Open-Racing-Telemetry/rtlm/README.md

<p align="center">
  
</p>
