Open-Racing-Telemetry/rtlm/kicad/rtlm/rtlm.kicad_pcb

## KiCad design kicad/rtlm/rtlm.kicad_pcb (2026-10-19)

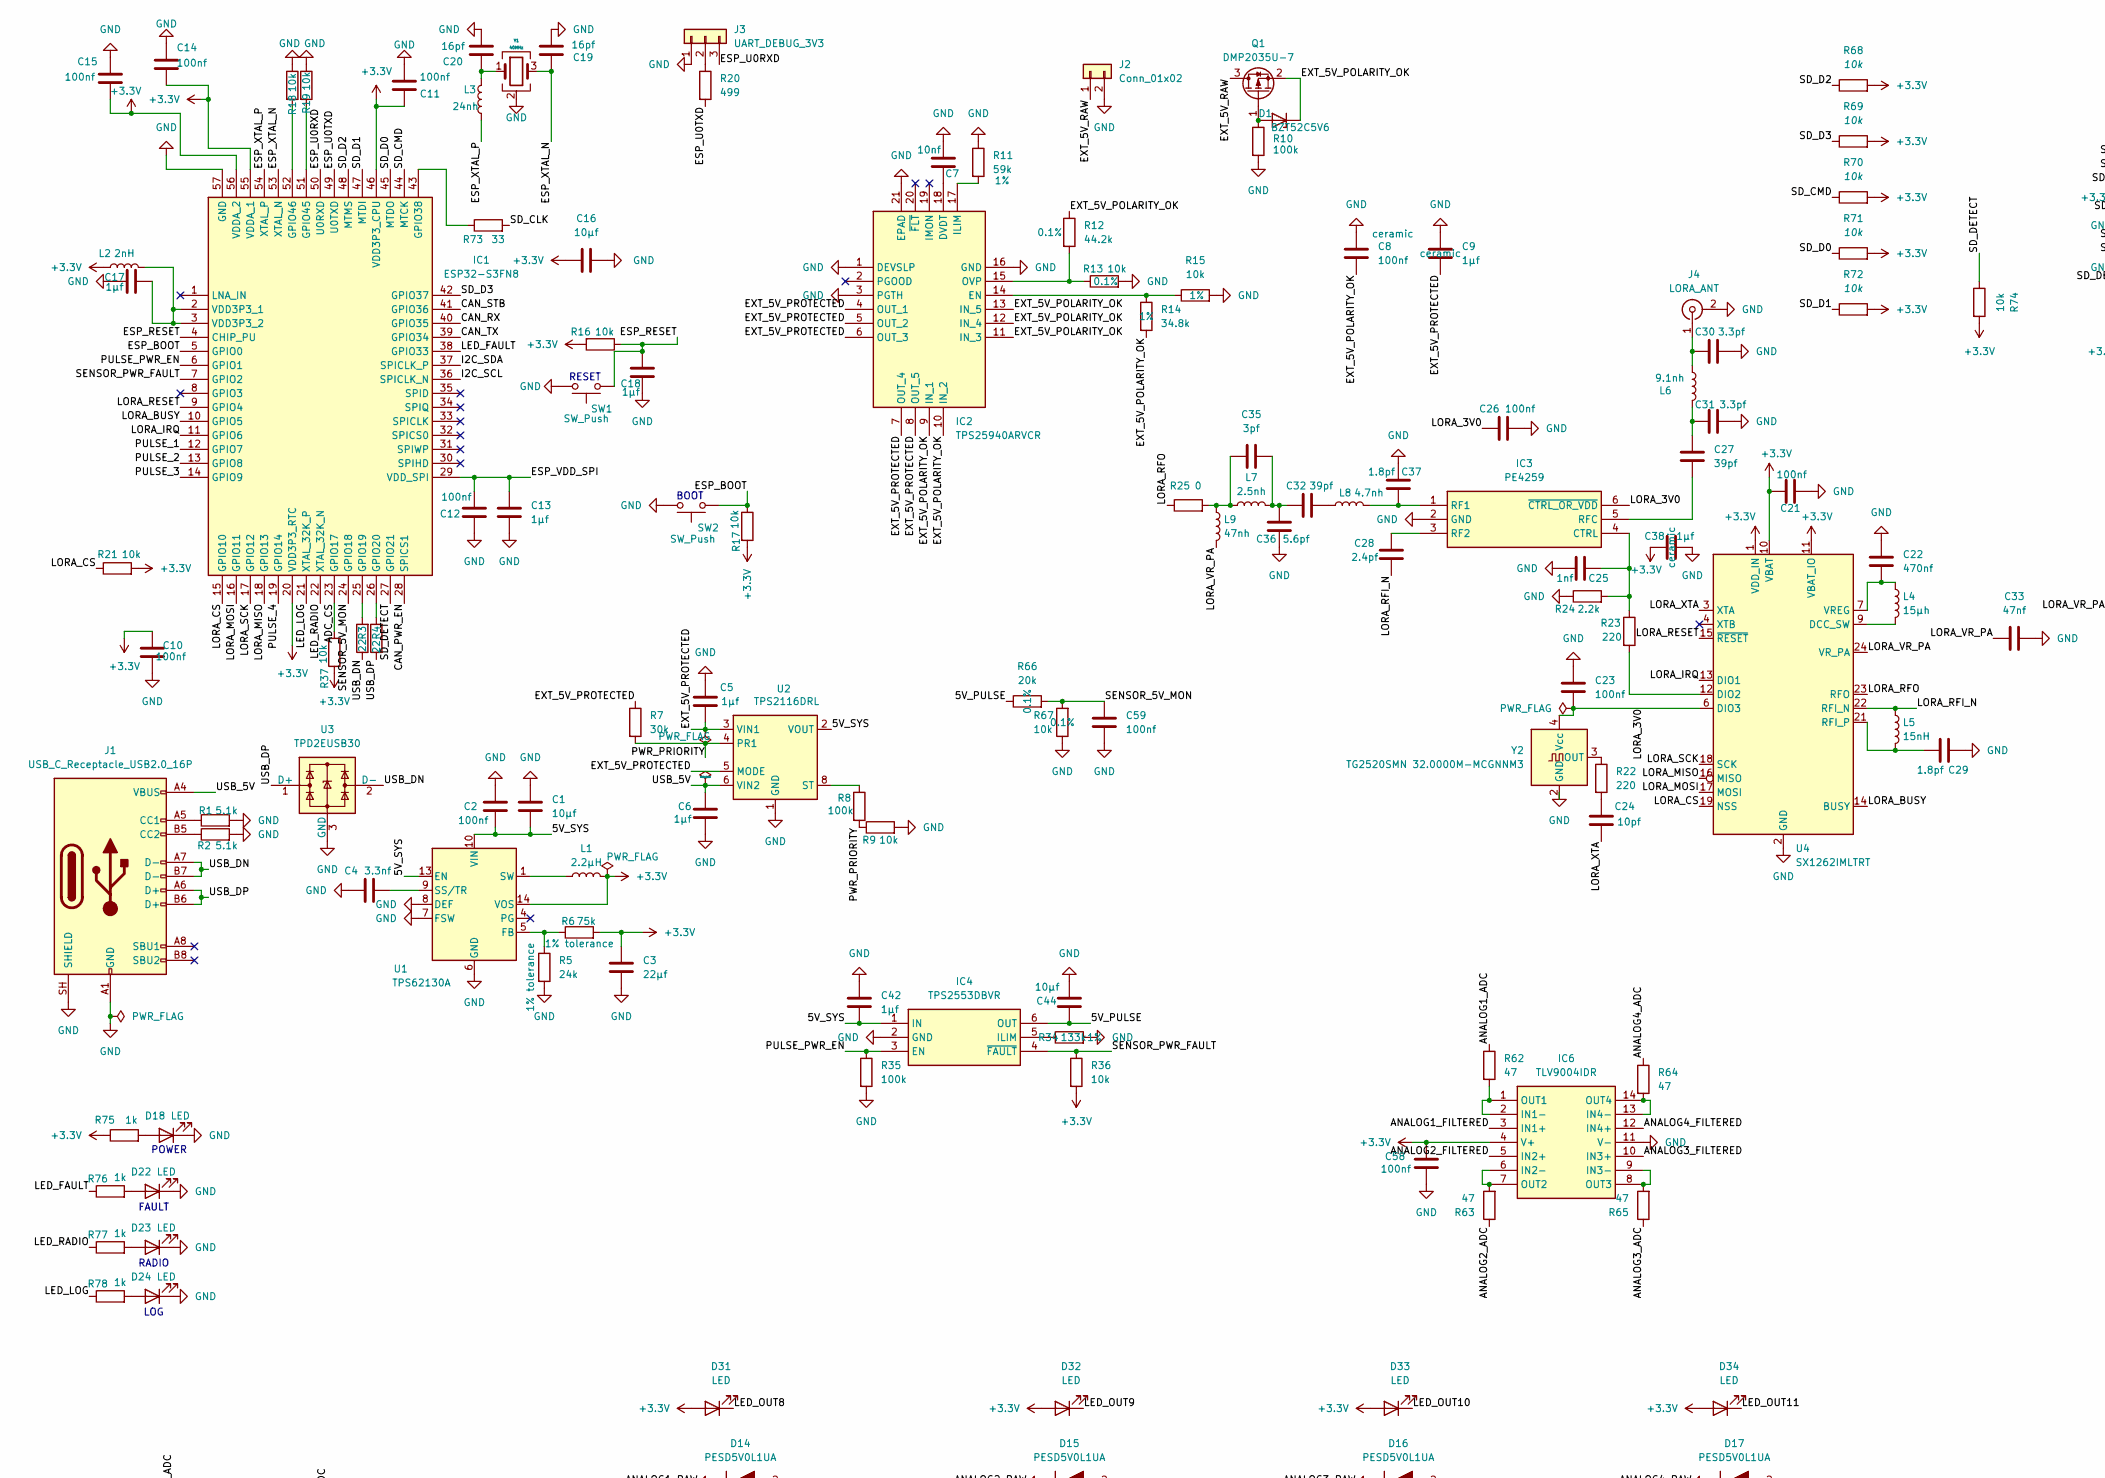
[picture p1: schematic rtlm.kicad_sch, part in row 1, column 1]

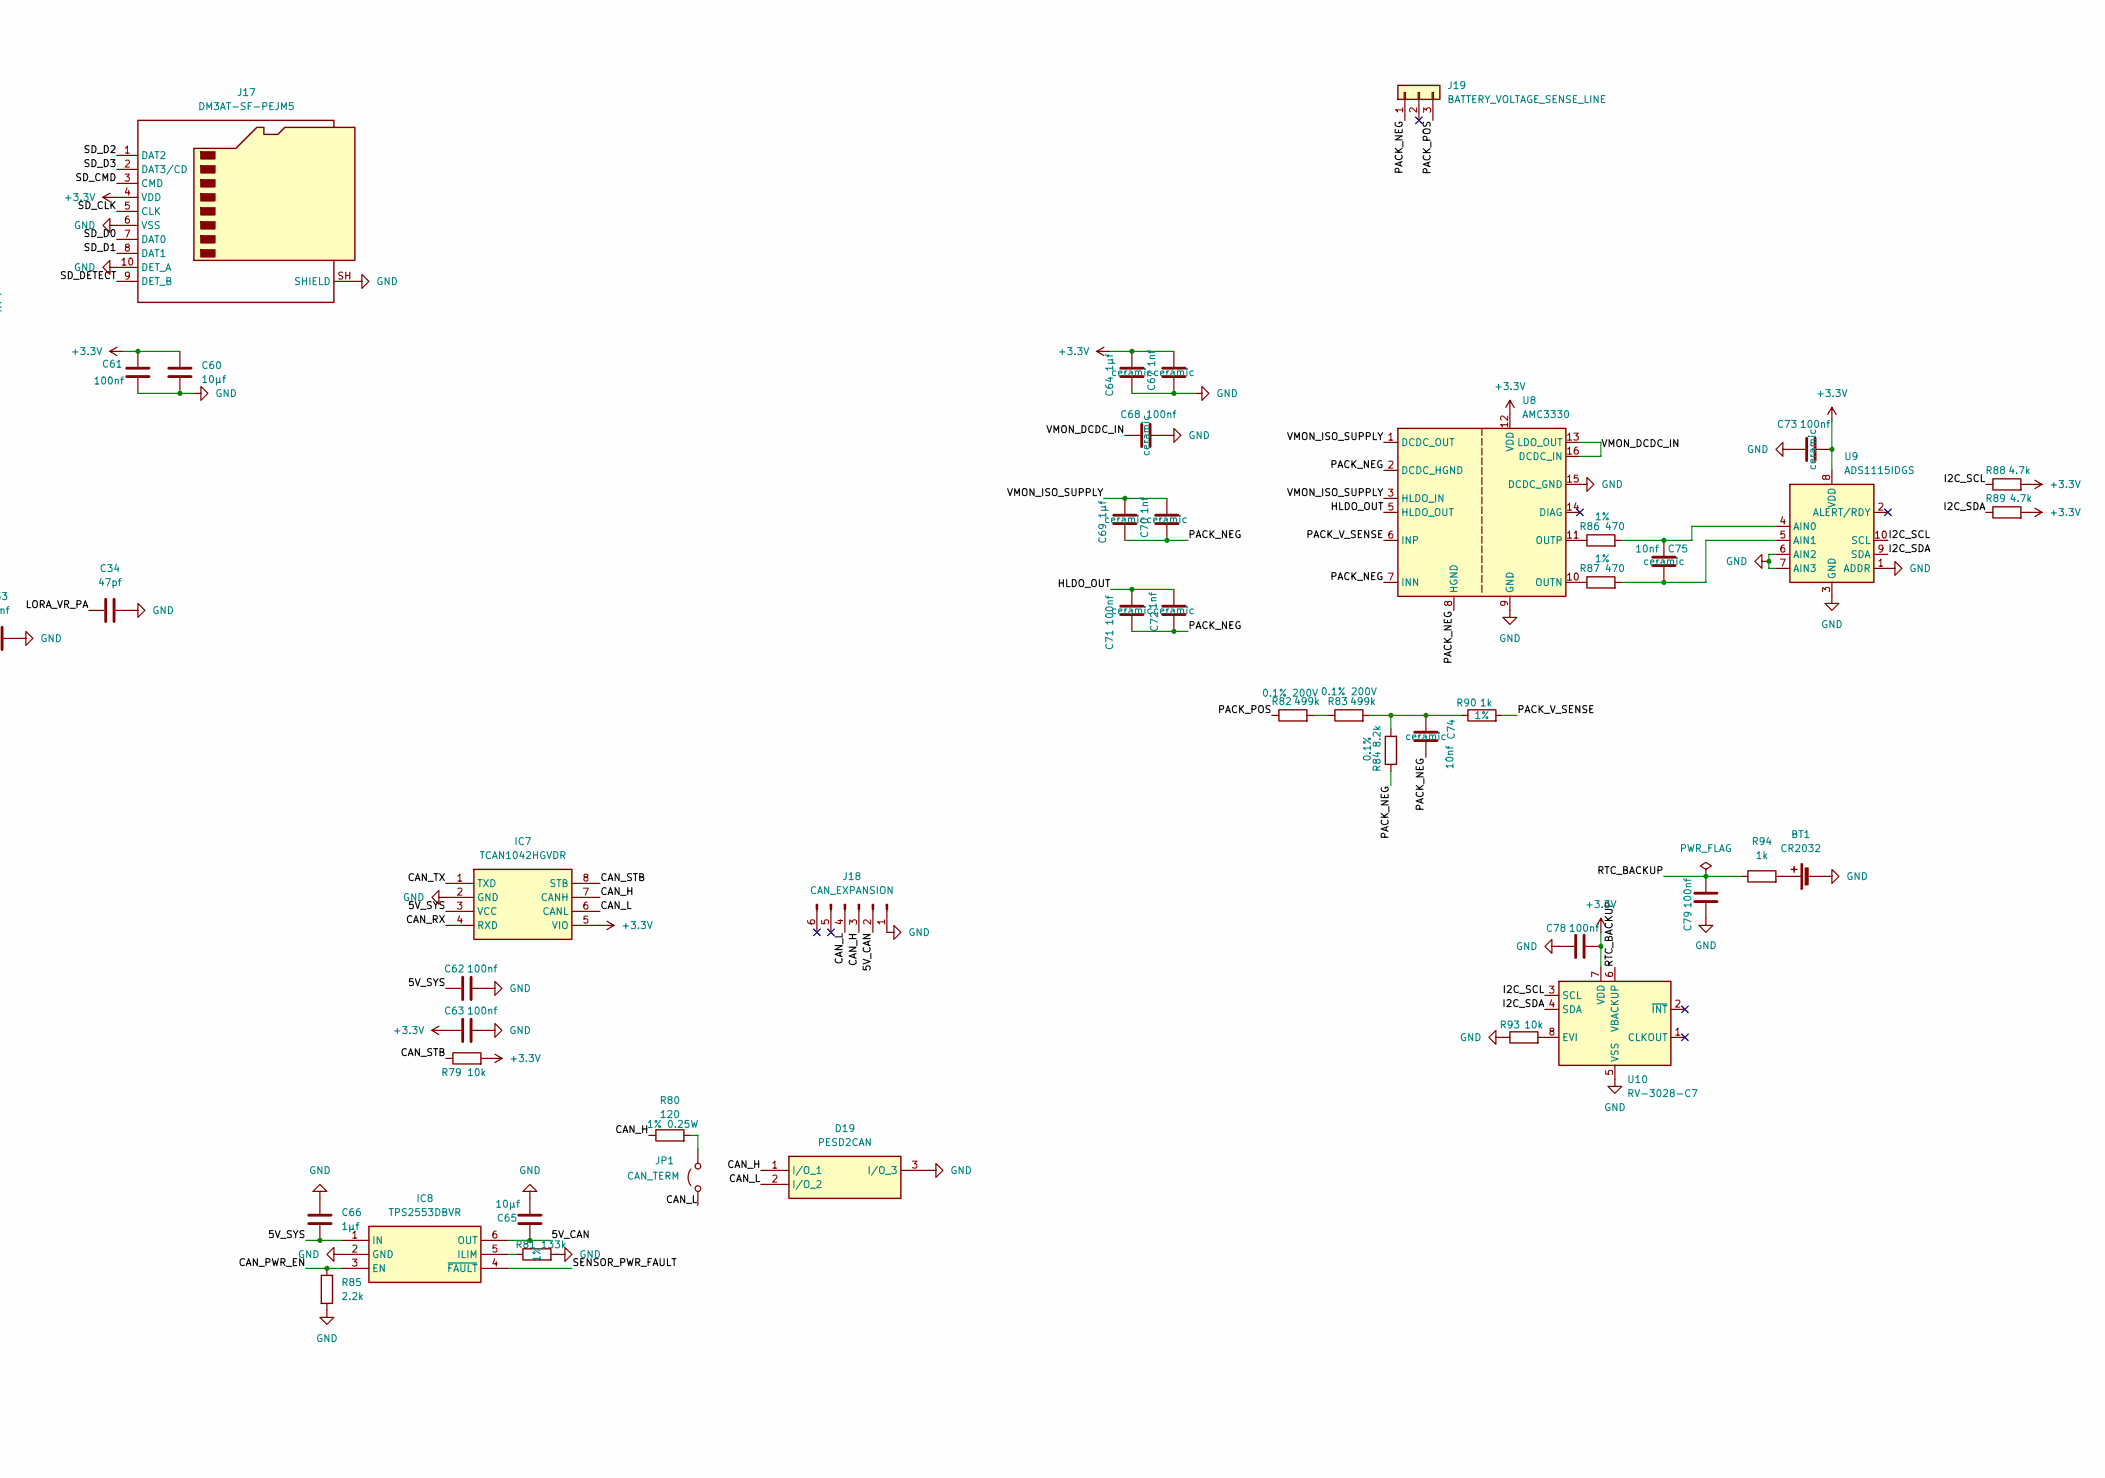
[picture p2: schematic rtlm.kicad_sch, part in row 1, column 2]

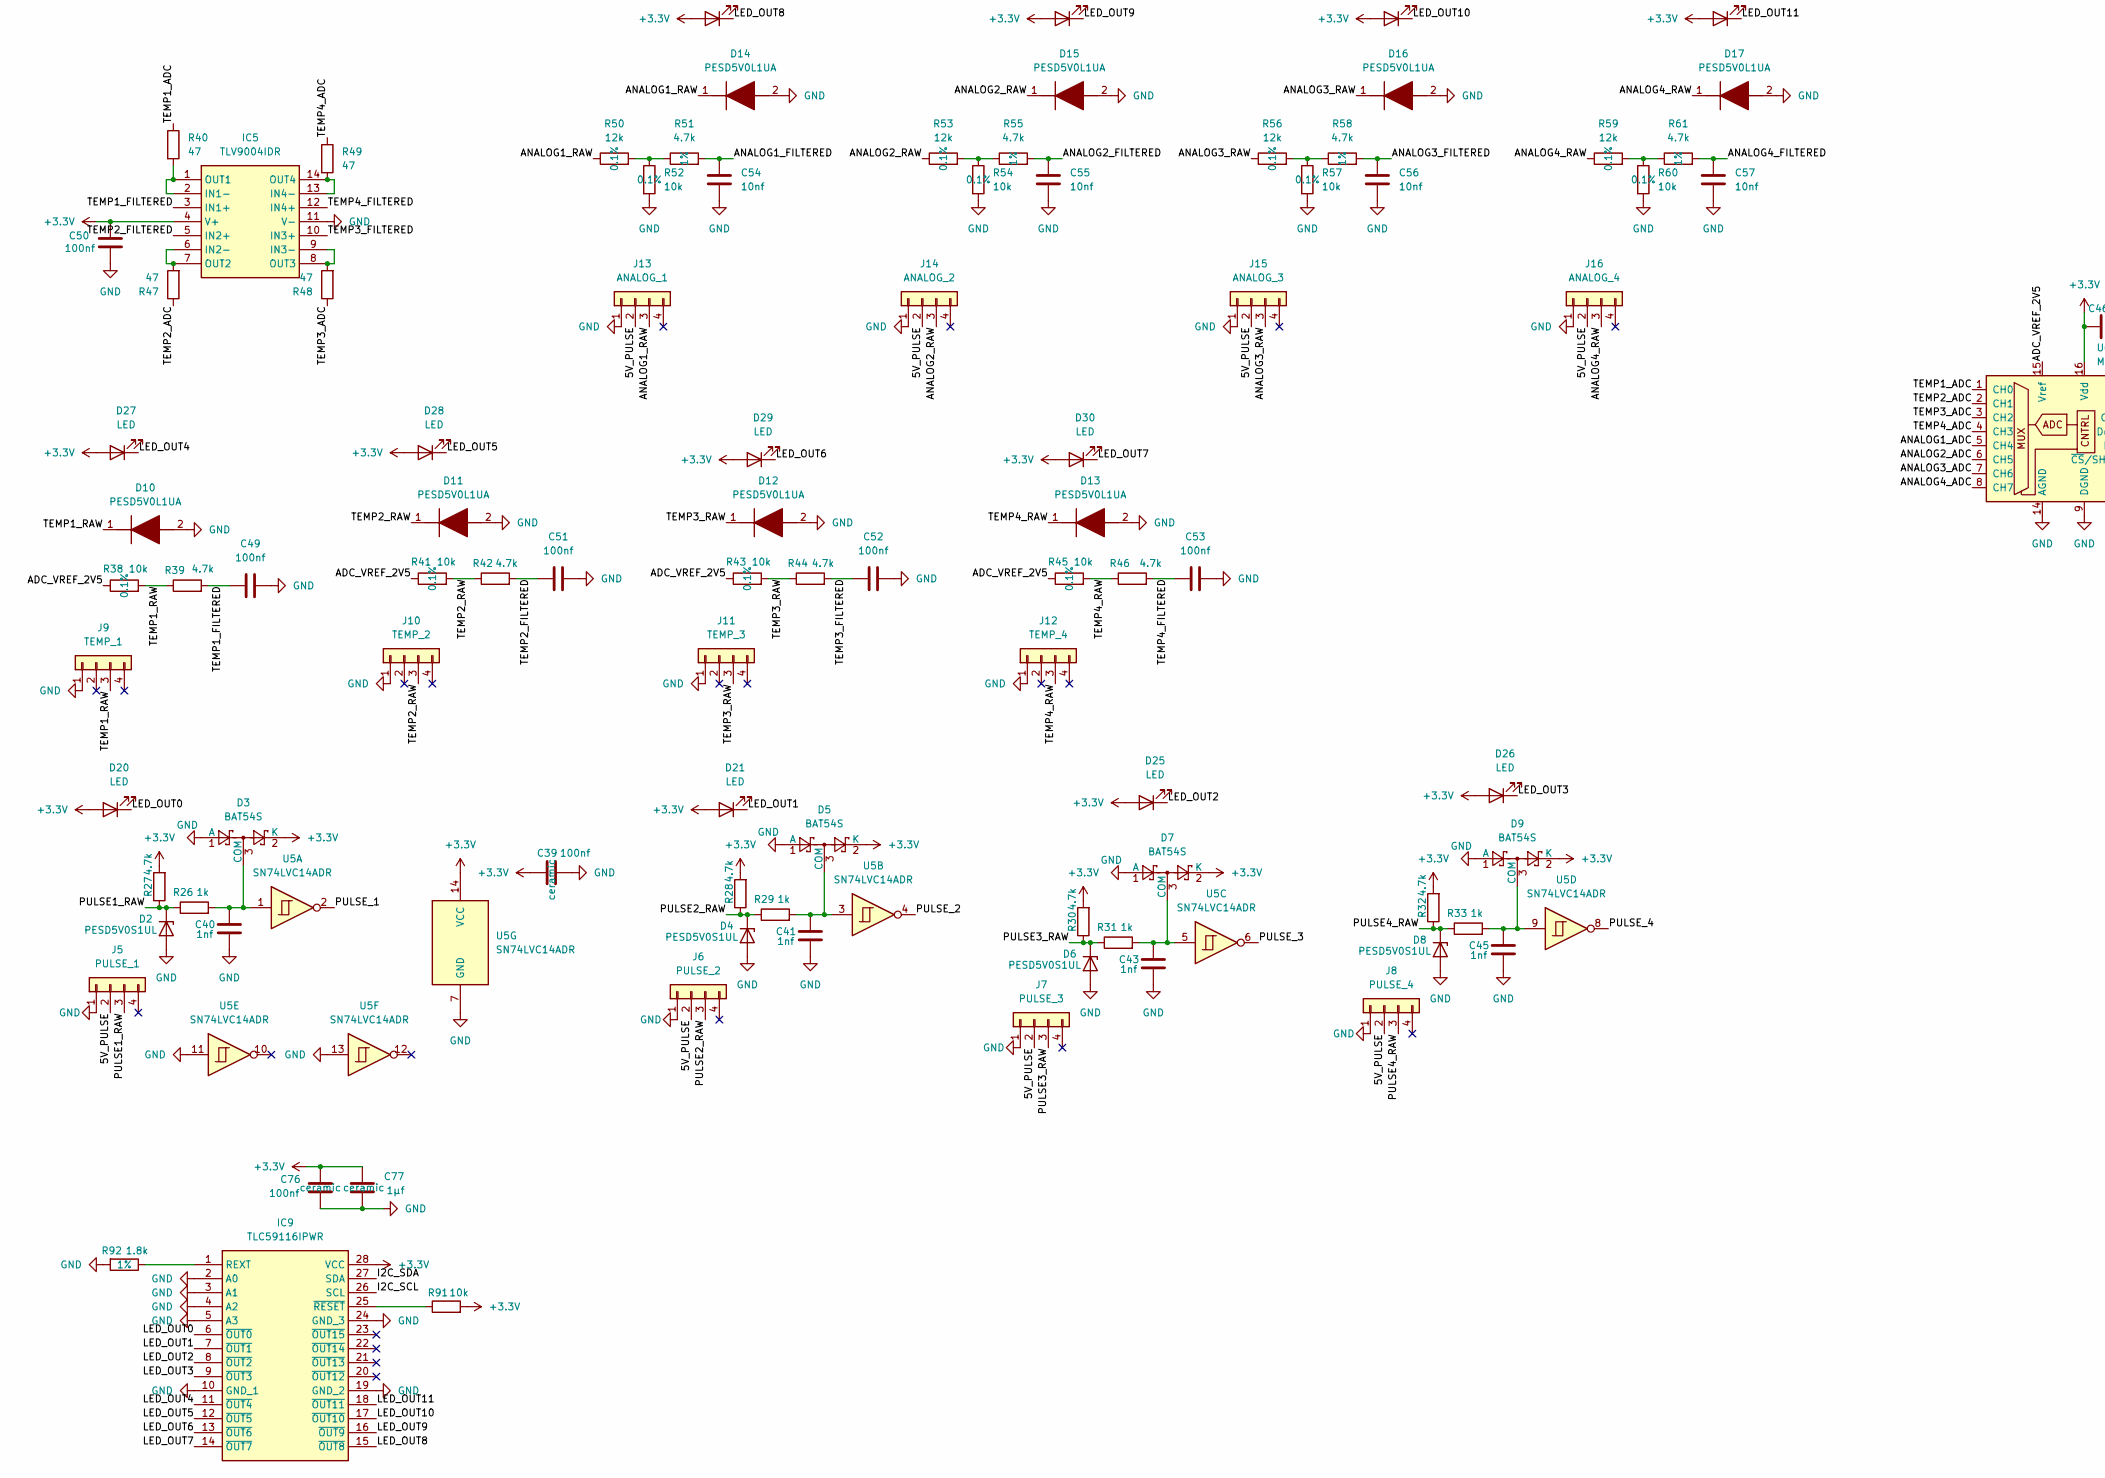
[picture p3: schematic rtlm.kicad_sch, part in row 2, column 1]

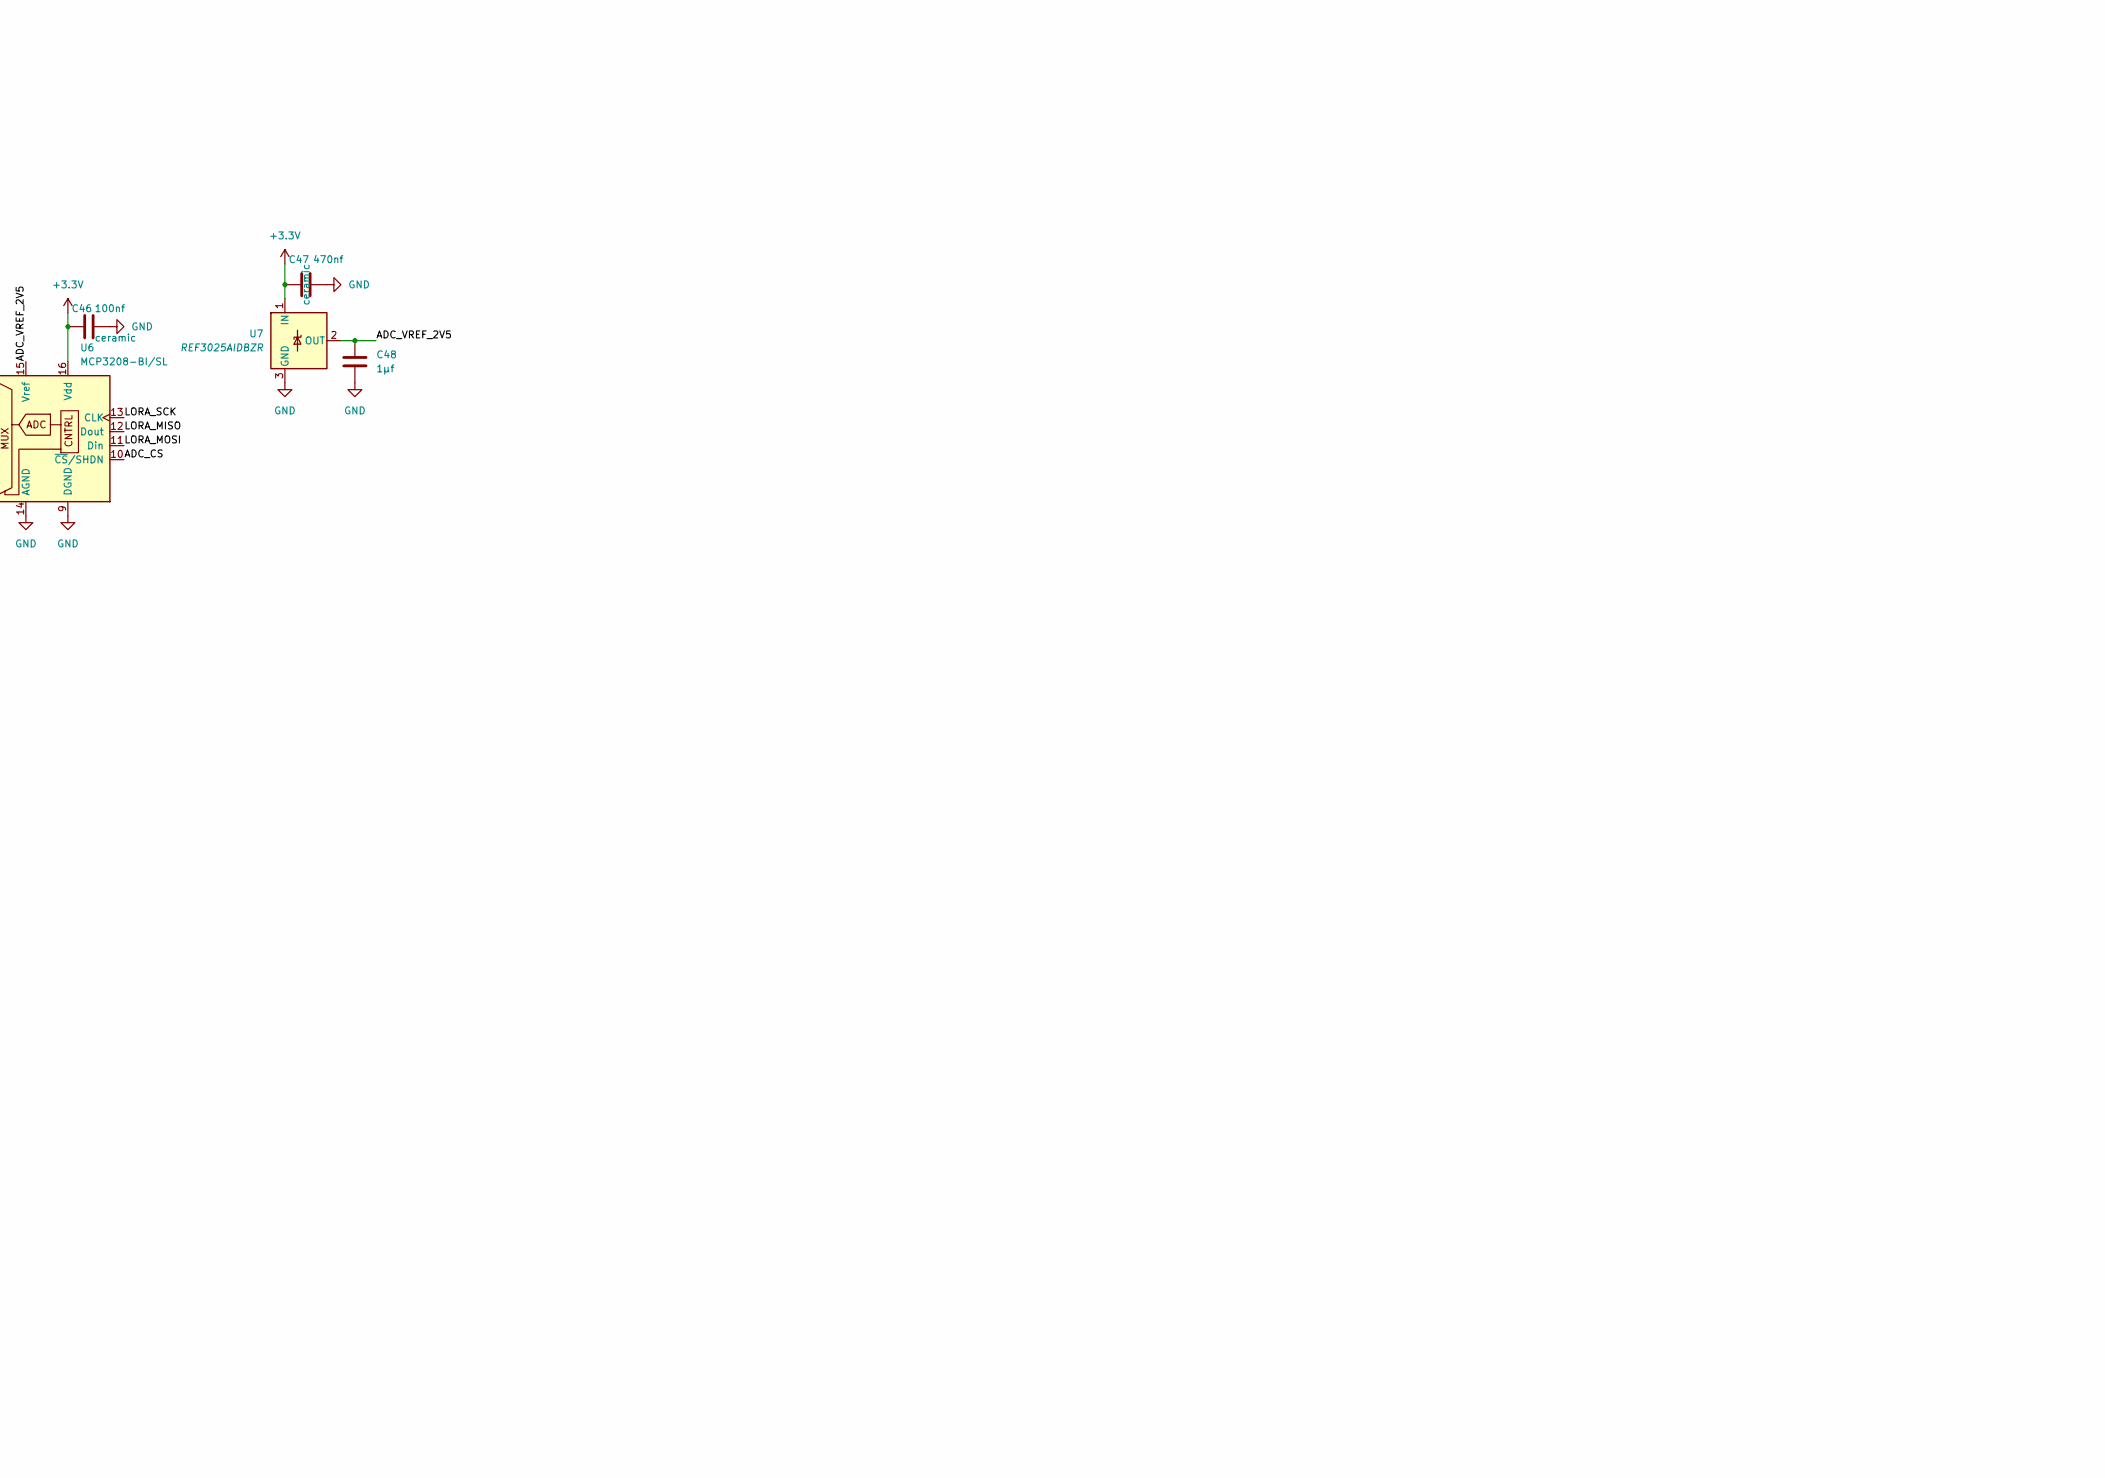
[picture p4: schematic rtlm.kicad_sch, part in row 2, column 2]

Parts:
BT1: CR2032; BatteryHolder_Keystone_1060_1x2032
C1, C16, C44, C60, C65: 10µf; C_0805_2012Metric
C2, C8, C10, C11, C12, C14, C15, C39, C46, C49, C50, C51, C52, C53, C58, C59, C61, C62, C63, C68, C73, C76, C78, C79: 100nf; C_0603_1608Metric
C3: 22µf; C_1206_3216Metric
C4: 3.3nf; C_0603_1608Metric
C5, C6, C9, C13, C17, C18, C38, C42, C48, C66, C69, C77: 1µf; C_0603_1608Metric
C7, C54, C55, C56, C57, C74, C75: 10nf; C_0603_1608Metric
C19, C20: 16pf; C_0603_1608Metric
C21, C23, C26: 100nf; C_0402_1005Metric
C22: 470nf; C_0402_1005Metric
C24: 10pf; C_0402_1005Metric
C25: 1nf; C_0402_1005Metric
C27, C32: 39pf; C_0402_1005Metric
C28: 2.4pf; C_0402_1005Metric
C29, C37: 1.8pf; C_0402_1005Metric
C30, C31: 3.3pf; C_0402_1005Metric
C33: 47nf; C_0402_1005Metric
C34: 47pf; C_0402_1005Metric
C35: 3pf; C_0402_1005Metric
C36: 5.6pf; C_0402_1005Metric
C40, C41, C43, C45, C70: 1nf; C_0603_1608Metric
C47: 470nf; C_0603_1608Metric
C64: 1µf; C_1206_3216Metric
C67, C72: 1nf; C_1206_3216Metric
C71: 100nf; C_1206_3216Metric
D1: BZT52C5V6; D_SOD-123
D2, D4, D6, D8: PESD5V0S1UL; D_SOD-882
D3, D5, D7, D9: BAT54S; SOT-23
D10, D11, D12, D13, D14, D15, D16, D17: PESD5V0L1UA; D_SOD-323; Manufacturer_Part_Number PESD5V0L1UA; Mouser Part Number N/A
D18, D20, D21, D22, D23, D24, D25, D26, D27, D28, D29, D30, D31, D32, D33, D34: LED; LED_0603_1608Metric
D19: PESD2CAN; SOT-23; Manufacturer_Part_Number PESD2CAN
IC1: ESP32-S3FN8; QFN40P700X700X90-57N-D; Manufacturer_Part_Number ESP32-S3FN8; Mouser Part Number 356-ESP32-S3FN8
IC2: TPS25940ARVCR; Texas_RVC0020A_WQFN-20-1EP_3x4mm_P0.5mm_EP1.6x2.6mm; Manufacturer_Part_Number TPS25940ARVCR; Mouser Part Number 595-TPS25940ARVCR
IC3: PE4259; SOT65P210X110-6N; Manufacturer_Part_Number PE4259; Mouser Part Number N/A
IC4, IC8: TPS2553DBVR; SOT-23-6; Manufacturer_Part_Number TPS2553DBVR; Mouser Part Number 595-TPS2553DBVR
IC5, IC6: TLV9004IDR; SOIC127P600X175-14N; Manufacturer_Part_Number TLV9004IDR; Mouser Part Number 595-TLV9004IDR
IC7: TCAN1042HGVDR; SOIC-8_3.9x4.9mm_P1.27mm; Manufacturer_Part_Number TCAN1042HGVDR; Mouser Part Number 595-TCAN1042HGVDR
IC9: TLC59116IPWR; SOP65P640X120-28N; Manufacturer_Part_Number TLC59116IPWR; Mouser Part Number 595-TLC59116IPWR
J1: USB_C_Receptacle_USB2.0_16P; USB_C_Receptacle_GCT_USB4105-xx-A_16P_TopMnt_Horizontal
J2: Conn_01x02; Molex_Micro-Fit_3.0_43650-0200_1x02_P3.00mm_Horizontal
J3: UART_DEBUG_3V3; PinHeader_1x03_P2.54mm_Vertical
J4: LORA_ANT; U.FL_Hirose_U.FL-R-SMT-1_Vertical
J5: PULSE_1; Molex_Micro-Fit_3.0_43045-0400_2x02_P3.00mm_Horizontal
J6: PULSE_2; Molex_Micro-Fit_3.0_43045-0400_2x02_P3.00mm_Horizontal
J7: PULSE_3; Molex_Micro-Fit_3.0_43045-0400_2x02_P3.00mm_Horizontal
J8: PULSE_4; Molex_Micro-Fit_3.0_43045-0400_2x02_P3.00mm_Horizontal
J9: TEMP_1; Molex_Micro-Fit_3.0_43045-0400_2x02_P3.00mm_Horizontal
J10: TEMP_2; Molex_Micro-Fit_3.0_43045-0400_2x02_P3.00mm_Horizontal
J11: TEMP_3; Molex_Micro-Fit_3.0_43045-0400_2x02_P3.00mm_Horizontal
J12: TEMP_4; Molex_Micro-Fit_3.0_43045-0400_2x02_P3.00mm_Horizontal
J13: ANALOG_1; Molex_Micro-Fit_3.0_43045-0400_2x02_P3.00mm_Horizontal
J14: ANALOG_2; Molex_Micro-Fit_3.0_43045-0400_2x02_P3.00mm_Horizontal
J15: ANALOG_3; Molex_Micro-Fit_3.0_43045-0400_2x02_P3.00mm_Horizontal
J16: ANALOG_4; Molex_Micro-Fit_3.0_43045-0400_2x02_P3.00mm_Horizontal
J17: DM3AT-SF-PEJM5; microSD_HC_Hirose_DM3AT-SF-PEJM5
J18: CAN_EXPANSION; Molex_Micro-Fit_3.0_43045-0600_2x03_P3.00mm_Horizontal
J19: BATTERY_VOLTAGE_SENSE_LINE; Molex_Micro-Fit_3.0_43650-0300_1x03_P3.00mm_Horizontal
JP1: CAN_TERM; PinHeader_1x02_P2.54mm_Vertical
L1: 2.2µH; L_Coilcraft_XxL4020
L2: 2nH; L_0402_1005Metric
L3: 24nh; L_0402_1005Metric
L4: 15µh; L_0603_1608Metric
L5: 15nH; L_0402_1005Metric
L6: 9.1nh; L_0402_1005Metric
L7: 2.5nh; L_0402_1005Metric
L8: 4.7nh; L_0402_1005Metric
L9: 47nh; L_0402_1005Metric
Q1: DMP2035U-7; SOT-23
R1, R2: 5.1k; R_0603_1608Metric
R3, R4: 22; R_0603_1608Metric
R5: 24k; R_0603_1608Metric
R6: 75k; R_0603_1608Metric
R7: 30k; R_0603_1608Metric
R8, R10, R35: 100k; R_0603_1608Metric
R9, R13, R15, R16, R17, R18, R19, R21, R36, R37, R38, R41, R43, R45, R52, R54, R57, R60, R67, R68, R69, R70, R71, R72, R74, R79, R91, R93: 10k; R_0603_1608Metric
R11: 59k; R_0603_1608Metric
R12: 44.2k; R_0603_1608Metric
R14: 34.8k; R_0603_1608Metric
R20: 499; R_0603_1608Metric
R22, R23: 220; R_0603_1608Metric
R24, R85: 2.2k; R_0603_1608Metric
R25: 0; R_0402_1005Metric
R26, R29, R31, R33, R75, R76, R77, R78, R90, R94: 1k; R_0603_1608Metric
R27, R28, R30, R32, R39, R42, R44, R46, R51, R55, R58, R61, R88, R89: 4.7k; R_0603_1608Metric
R34, R81: 133k; R_0603_1608Metric
R40, R47, R48, R49, R62, R63, R64, R65: 47; R_0603_1608Metric
R50, R53, R56, R59: 12k; R_0603_1608Metric
R66: 20k; R_0603_1608Metric
R73: 33; R_0603_1608Metric
R80: 120; R_1206_3216Metric
R82, R83: 499k; R_1206_3216Metric
R84: 8.2k; R_0603_1608Metric
R86, R87: 470; R_0603_1608Metric
R92: 1.8k; R_0603_1608Metric
SW1, SW2: SW_Push; SW_Tactile_SPST_NO_Straight_CK_PTS636Sx25SMTRLFS
U1: TPS62130A; VQFN-16-1EP_3x3mm_P0.5mm_EP1.68x1.68mm
U2: TPS2116DRL; SOT-583-8
U3: TPD2EUSB30; Texas_DRT-3
U4: SX1262IMLTRT; QFN-24-1EP_4x4mm_P0.5mm_EP2.6x2.6mm
U5: SN74LVC14ADR; SOIC-14_3.9x8.7mm_P1.27mm
U6: MCP3208-BI/SL; SOIC-16_3.9x9.9mm_P1.27mm
U7: REF3025AIDBZR; SOT-23
U8: AMC3330; SOIC-16W_7.5x10.3mm_P1.27mm
U9: ADS1115IDGS; TSSOP-10_3x3mm_P0.5mm
U10: RV-3028-C7; MicroCrystal_C7_SON-8_1.5x3.2mm_P0.9mm
Y1: 40MHz; Crystal_SMD_SeikoEpson_FA128-4Pin_2.0x1.6mm
Y2: TG2520SMN 32.0000M-MCGNNM3; Oscillator_SMD_SeikoEpson_TG2520SMN-xxx-xxxxxx-4Pin_2.5x2.0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

Connections:
+3.3V: C3.1, C10.2, C11.2, C14.2, C15.2, C16.1, C21.1, C38.1, C39.1, C46.1, C47.1, C50.1, C58.1, C60.1, C61.1, C63.1, C64.2, C67.2, C73.2, C76.1, C77.1, C78.2, D3.2 (K), D5.2 (K), D7.2 (K), D9.2 (K), D20.2 (A), D21.2 (A), D25.2 (A), D26.2 (A), D27.2 (A), D28.2 (A), D29.2 (A), D30.2 (A), D31.2 (A), D32.2 (A), D33.2 (A), D34.2 (A), IC1.20 (VDD3P3_RTC), IC1.46 (VDD3P3_CPU), IC1.55 (VDDA_1), IC1.56 (VDDA_2), IC5.4 (V+), IC6.4 (V+), IC7.5 (VIO), IC9.28 (VCC), J17.4 (VDD), L1.2, L2.1, R6.2, R16.2, R17.2, R21.2, R27.2, R28.2, R30.2, R32.2, R36.2, R37.1, R68.2, R69.2, R70.2, R71.2, R72.2, R74.2, R75.1, R79.2, R88.2, R89.2, R91.2, U1.14 (VOS), U4.1 (VDD_IN), U4.10 (VBAT), U4.11 (VBAT_IO), U5.14 (VCC), U6.16 (Vdd), U7.1 (IN), U8.12 (VDD), U9.8 (VDD), U10.7 (VDD)
/5V_CAN: C65.2, IC8.6 (OUT), J18.2
/5V_PULSE: C44.2, IC4.6 (OUT), J5.2, J6.2, J7.2, J8.2, J13.2, J14.2, J15.2, J16.2, R66.1
/5V_SYS: C1.2, C2.2, C42.2, C62.1, C66.2, IC4.1 (IN), IC7.3 (VCC), IC8.1 (IN), U1.10 (VIN), U1.11 (VIN), U1.12 (VIN), U1.13 (EN), U2.2 (VOUT), U2.7 (VOUT)
/ADC_CS: IC1.23 (GPIO17), R37.2, U6.10 (~CS/SHDN)
/ADC_VREF_2V5: C48.1, R38.1, R41.1, R43.1, R45.1, U6.15 (Vref), U7.2 (OUT)
/ANALOG1_ADC: R62.1, U6.5 (CH4)
/ANALOG1_FILTERED: C54.1, IC6.3 (IN1+), R51.2
/ANALOG1_RAW: D14.1 (K), J13.3, R50.1
/ANALOG2_ADC: R63.1, U6.6 (CH5)
/ANALOG2_FILTERED: C55.1, IC6.5 (IN2+), R55.2
/ANALOG2_RAW: D15.1 (K), J14.3, R53.1
/ANALOG3_ADC: R65.1, U6.7 (CH6)
/ANALOG3_FILTERED: C56.1, IC6.10 (IN3+), R58.2
/ANALOG3_RAW: D16.1 (K), J15.3, R56.1
/ANALOG4_ADC: R64.1, U6.8 (CH7)
/ANALOG4_FILTERED: C57.1, IC6.12 (IN4+), R61.2
/ANALOG4_RAW: D17.1 (K), J16.3, R59.1
/CAN_H: D19.1 (I/O_1), IC7.7 (CANH), J18.3, R80.1
/CAN_L: D19.2 (I/O_2), IC7.6 (CANL), J18.4, JP1.1 (A)
/CAN_PWR_EN: IC1.28 (SPICS1), IC8.3 (EN), R85.1
/CAN_RX: IC1.40 (GPIO35), IC7.4 (RXD)
/CAN_STB: IC1.41 (GPIO36), IC7.8 (STB), R79.1
/CAN_TX: IC1.39 (GPIO34), IC7.1 (TXD)
/ESP_BOOT: IC1.5 (GPIO0), R17.1, SW2.1
/ESP_RESET: C18.2, IC1.4 (CHIP_PU), R16.1, SW1.1
/ESP_U0RXD: IC1.50 (U0RXD), J3.3
/ESP_U0TXD: IC1.49 (U0TXD), R20.2
/ESP_VDD_SPI: C12.1, C13.1, IC1.29 (VDD_SPI)
/ESP_XTAL_N: C19.2, IC1.53 (XTAL_N), Y1.3
/ESP_XTAL_P: IC1.54 (XTAL_P), L3.1
/EXT_5V_POLARITY_OK: C8.2, D1.1 (K), IC2.9 (IN_1), IC2.10 (IN_2), IC2.11 (IN_3), IC2.12 (IN_4), IC2.13 (IN_5), Q1.2 (S), R12.1, R14.2
/EXT_5V_PROTECTED: C5.2, C9.2, IC2.4 (OUT_1), IC2.5 (OUT_2), IC2.6 (OUT_3), IC2.7 (OUT_4), IC2.8 (OUT_5), R7.1, U2.3 (VIN1), U2.5 (MODE)
/EXT_5V_RAW: J2.1, Q1.3 (D)
/HLDO_OUT: C71.2, C72.2, U8.5 (HLDO_OUT)
/I2C_SCL: IC1.36 (SPICLK_N), IC9.26 (SCL), R88.1, U9.10 (SCL), U10.3 (SCL)
/I2C_SDA: IC1.37 (SPICLK_P), IC9.27 (SDA), R89.1, U9.9 (SDA), U10.4 (SDA)
/LED_FAULT: IC1.38 (GPIO33), R76.1
/LED_LOG: IC1.21 (XTAL_32K_P), R78.1
/LED_OUT0: D20.1 (K), IC9.6 (~OUT0)
/LED_OUT1: D21.1 (K), IC9.7 (~OUT1)
/LED_OUT2: D25.1 (K), IC9.8 (~OUT2)
/LED_OUT3: D26.1 (K), IC9.9 (~OUT3)
/LED_OUT4: D27.1 (K), IC9.11 (~OUT4)
/LED_OUT5: D28.1 (K), IC9.12 (~OUT5)
/LED_OUT6: D29.1 (K), IC9.13 (~OUT6)
/LED_OUT7: D30.1 (K), IC9.14 (~OUT7)
/LED_OUT8: D31.1 (K), IC9.15 (~OUT8)
/LED_OUT9: D32.1 (K), IC9.16 (~OUT9)
/LED_OUT10: D33.1 (K), IC9.17 (~OUT10)
/LED_OUT11: D34.1 (K), IC9.18 (~OUT11)
/LED_RADIO: IC1.22 (XTAL_32K_N), R77.1
/LORA_3V0: C23.2, C26.2, IC3.6 (~CTRL_OR_VDD), U4.6 (DIO3), Y2.4 (Vcc)
/LORA_BUSY: IC1.10 (GPIO5), U4.14 (BUSY)
/LORA_CS: IC1.15 (GPIO10), R21.1, U4.19 (NSS)
/LORA_IRQ: IC1.11 (GPIO6), U4.13 (DIO1)
/LORA_MISO: IC1.18 (GPIO13), U4.16 (MISO), U6.12 (Dout)
/LORA_MOSI: IC1.16 (GPIO11), U4.17 (MOSI), U6.11 (Din)
/LORA_RESET: IC1.9 (GPIO4), U4.15 (~RESET)
/LORA_RFI_N: C28.2, L5.1, U4.22 (RFI_N)
/LORA_RFO: R25.1, U4.23 (RFO)
/LORA_SCK: IC1.17 (GPIO12), U4.18 (SCK), U6.13 (CLK)
/LORA_VR_PA: C33.1, C34.1, L9.2, U4.24 (VR_PA)
/LORA_XTA: C24.2, U4.3 (XTA)
/PACK_NEG: C69.1, C70.1, C71.1, C72.1, C74.2, J19.1, R84.1, U8.2 (DCDC_HGND), U8.7 (INN), U8.8 (HGND)
/PACK_POS: J19.3, R82.1
/PACK_V_SENSE: R90.2, U8.6 (INP)
/PULSE1_RAW: D2.1 (K), J5.3, R26.1, R27.1
/PULSE2_RAW: D4.1 (K), J6.3, R28.1, R29.1
/PULSE3_RAW: D6.1 (K), J7.3, R30.1, R31.1
/PULSE4_RAW: D8.1 (K), J8.3, R32.1, R33.1
/PULSE_1: IC1.12 (GPIO7), U5.2
/PULSE_2: IC1.13 (GPIO8), U5.4
/PULSE_3: IC1.14 (GPIO9), U5.6
/PULSE_4: IC1.19 (GPIO14), U5.8
/PULSE_PWR_EN: IC1.6 (GPIO1), IC4.3 (EN), R35.1
/PWR_PRIORITY: R7.2, R8.2, R9.1, U2.4 (PR1)
/RTC_BACKUP: C79.2, R94.1, U10.6 (VBACKUP)
/SD_CLK: J17.5 (CLK), R73.2
/SD_CMD: IC1.44 (MTCK), J17.3 (CMD), R70.1
/SD_D0: IC1.45 (MTDO), J17.7 (DAT0), R71.1
/SD_D1: IC1.47 (MTDI), J17.8 (DAT1), R72.1
/SD_D2: IC1.48 (MTMS), J17.1 (DAT2), R68.1
/SD_D3: IC1.42 (GPIO37), J17.2 (DAT3/CD), R69.1
/SD_DETECT: IC1.27 (GPIO21), J17.9 (DET_B), R74.1
/SENSOR_5V_MON: C59.1, IC1.24 (GPIO18), R66.2, R67.2
/SENSOR_PWR_FAULT: IC1.7 (GPIO2), IC4.4 (~FAULT), IC8.4 (~FAULT), R36.1
/TEMP1_ADC: R40.1, U6.1 (CH0)
/TEMP1_FILTERED: C49.1, IC5.3 (IN1+), R39.2
/TEMP1_RAW: D10.1 (K), J9.3, R38.2, R39.1
/TEMP2_ADC: R47.1, U6.2 (CH1)
/TEMP2_FILTERED: C51.1, IC5.5 (IN2+), R42.2
/TEMP2_RAW: D11.1 (K), J10.3, R41.2, R42.1
/TEMP3_ADC: R48.1, U6.3 (CH2)
/TEMP3_FILTERED: C52.1, IC5.10 (IN3+), R44.2
/TEMP3_RAW: D12.1 (K), J11.3, R43.2, R44.1
/TEMP4_ADC: R49.1, U6.4 (CH3)
/TEMP4_FILTERED: C53.1, IC5.12 (IN4+), R46.2
/TEMP4_RAW: D13.1 (K), J12.3, R45.2, R46.1
/USB_5V: C6.1, J1.A4 (VBUS), J1.A9 (VBUS), J1.B4 (VBUS), J1.B9 (VBUS), U2.6 (VIN2)
/USB_DN: J1.A7 (D-), J1.B7 (D-), R3.1, U3.2 (D-)
/USB_DP: J1.A6 (D+), J1.B6 (D+), R4.1, U3.1 (D+)
/VMON_DCDC_IN: C68.1, U8.13 (LDO_OUT), U8.16 (DCDC_IN)
/VMON_ISO_SUPPLY: C69.2, C70.2, U8.1 (DCDC_OUT), U8.3 (HLDO_IN)
GND: BT1.2 (-), C1.1, C2.1, C3.2, C4.1, C5.1, C6.2, C7.1, C8.1, C9.1, C10.1, C11.1, C12.2, C13.2, C14.1, C15.1, C16.2, C17.1, C18.1, C19.1, C20.1, C21.2, C22.1, C23.1, C25.1, C26.1, C29.1, C30.2, C31.2, C33.2, C34.2, C36.2, C37.2, C38.2, C39.2, C40.2, C41.2, C42.1, C43.2, C44.1, C45.2, C46.2, C47.2, C48.2, C49.2, C50.2, C51.2, C52.2, C53.2, C54.2, C55.2, C56.2, C57.2, C58.2, C59.2, C60.2, C61.2, C62.2, C63.2, C64.1, C65.1, C66.1, C67.1, C68.2, C73.1, C76.2, C77.2, C78.1, C79.1, D2.2 (A), D3.1 (A), D4.2 (A), D5.1 (A), D6.2 (A), D7.1 (A), D8.2 (A), D9.1 (A), D10.2 (A), D11.2 (A), D12.2 (A), D13.2 (A), D14.2 (A), D15.2 (A), D16.2 (A), D17.2 (A), D18.1 (K), D19.3 (I/O_3), D22.1 (K), D23.1 (K), D24.1 (K), IC1.57 (GND), IC2.1 (DEVSLP), IC2.3 (PGTH), IC2.16 (GND), IC2.21 (EPAD), IC3.2 (GND), IC4.2 (GND), IC5.11 (V-), IC6.11 (V-), IC7.2 (GND), IC8.2 (GND), IC9.2 (A0), IC9.3 (A1), IC9.4 (A2), IC9.5 (A3), IC9.10 (GND_1), IC9.19 (GND_2), IC9.24 (GND_3), J1.A1 (GND), J1.A12 (GND), J1.B1 (GND), J1.B12 (GND), J1.SH (SHIELD), J2.2, J3.1, J4.2 (Ext), J5.1, J6.1, J7.1, J8.1, J9.1, J10.1, J11.1, J12.1, J13.1, J14.1, J15.1, J16.1, J17.6 (VSS), J17.10 (DET_A), J17.SH (SHIELD), J18.1, R1.2, R2.2, R5.2, R9.2, R10.2, R11.1, R13.2, R15.2, R18.1, R19.1, R24.1, R34.2, R35.2, R52.2, R54.2, R57.2, R60.2, R67.1, R81.2, R85.2, R92.2, R93.1, SW1.2, SW2.2, U1.6 (GND), U1.7 (FSW), U1.8 (DEF), U1.15 (GND), U1.16 (GND), U1.17 (GND), U2.1 (GND), U3.3 (GND), U4.2 (GND), U4.5 (GND), U4.8 (GND), U4.20 (GND), U4.25 (GND), U5.7 (GND), U5.11, U5.13, U6.9 (DGND), U6.14 (AGND), U7.3 (GND), U8.9 (GND), U8.15 (DCDC_GND), U9.1 (ADDR), U9.3 (GND), U9.6 (AIN2), U9.7 (AIN3), U10.5 (VSS), Y1.2 (G), Y1.4 (G), Y2.2 (GND)
unnamed: BT1.1 (+), R94.2
unnamed: C20.2, L3.2, Y1.1
unnamed: C24.1, R22.2
unnamed: C27.1, C31.1, L6.2
unnamed: C32.1, C35.2, C36.1, L7.2
unnamed: C32.2, L8.1
unnamed: C35.1, L7.1, L9.1, R25.2
unnamed: C74.1, R83.2, R84.2, R90.1
unnamed: D1.2 (A), Q1.1 (G), R10.1
unnamed: C40.1, D3.3 (COM), R26.2, U5.1
unnamed: C41.1, D5.3 (COM), R29.2, U5.3
unnamed: C43.1, D7.3 (COM), R31.2, U5.5
unnamed: C45.1, D9.3 (COM), R33.2, U5.9
unnamed: D18.2 (A), R75.2
unnamed: D22.2 (A), R76.2
unnamed: D23.2 (A), R77.2
unnamed: D24.2 (A), R78.2
unnamed: IC1.25 (GPIO19), R3.2
unnamed: IC1.26 (GPIO20), R4.2
unnamed: IC1.43 (GPIO38), R73.1
unnamed: IC1.51 (GPIO45), R19.2
unnamed: IC1.52 (GPIO46), R18.2
unnamed: C17.2, IC1.2 (VDD3P3_1), IC1.3 (VDD3P3_2), L2.2
unnamed: C7.2, IC2.18 (DVDT)
unnamed: IC2.14 (EN), R14.1, R15.1
unnamed: IC2.17 (ILIM), R11.2
unnamed: IC2.15 (OVP), R12.2, R13.1
unnamed: C25.2, IC3.4 (CTRL), R23.1, R24.2
unnamed: C37.1, IC3.1 (RF1), L8.2
unnamed: C28.1, IC3.3 (RF2)
unnamed: C27.2, IC3.5 (RFC)
unnamed: IC4.5 (ILIM), R34.1
unnamed: IC5.1 (OUT1), IC5.2 (IN1-), R40.2
unnamed: IC5.6 (IN2-), IC5.7 (OUT2), R47.2
unnamed: IC5.8 (OUT3), IC5.9 (IN3-), R48.2
unnamed: IC5.13 (IN4-), IC5.14 (OUT4), R49.2
unnamed: IC6.1 (OUT1), IC6.2 (IN1-), R62.2
unnamed: IC6.6 (IN2-), IC6.7 (OUT2), R63.2
unnamed: IC6.8 (OUT3), IC6.9 (IN3-), R65.2
unnamed: IC6.13 (IN4-), IC6.14 (OUT4), R64.2
unnamed: IC8.5 (ILIM), R81.1
unnamed: IC9.1 (REXT), R92.1
unnamed: IC9.25 (~RESET), R91.1
unnamed: J1.A5 (CC1), R1.1
unnamed: J1.B5 (CC2), R2.1
unnamed: J3.2, R20.1
unnamed: C30.1, J4.1 (In), L6.1
unnamed: JP1.2 (B), R80.2
unnamed: L1.1, U1.1 (SW), U1.2 (SW), U1.3 (SW)
unnamed: R50.2, R51.1, R52.1
unnamed: R53.2, R54.1, R55.1
unnamed: R56.2, R57.1, R58.1
unnamed: R59.2, R60.1, R61.1
unnamed: R82.2, R83.1
unnamed: R5.1, R6.1, U1.5 (FB)
unnamed: C4.2, U1.9 (SS/TR)
unnamed: R8.1, U2.8 (ST)
unnamed: L4.2, U4.9 (DCC_SW)
unnamed: R23.2, U4.12 (DIO2)
unnamed: C29.2, L5.2, U4.21 (RFI_P)
unnamed: C22.2, L4.1, U4.7 (VREG)
unnamed: R87.1, U8.10 (OUTN)
unnamed: R86.1, U8.11 (OUTP)
unnamed: C75.1, R86.2, U9.4 (AIN0)
unnamed: C75.2, R87.2, U9.5 (AIN1)
unnamed: R93.2, U10.8 (EVI)
unnamed: R22.1, Y2.3 (OUT)

Notes on the sheet:
RESET
FAULT
POWER
BOOT
RADIO
LOG

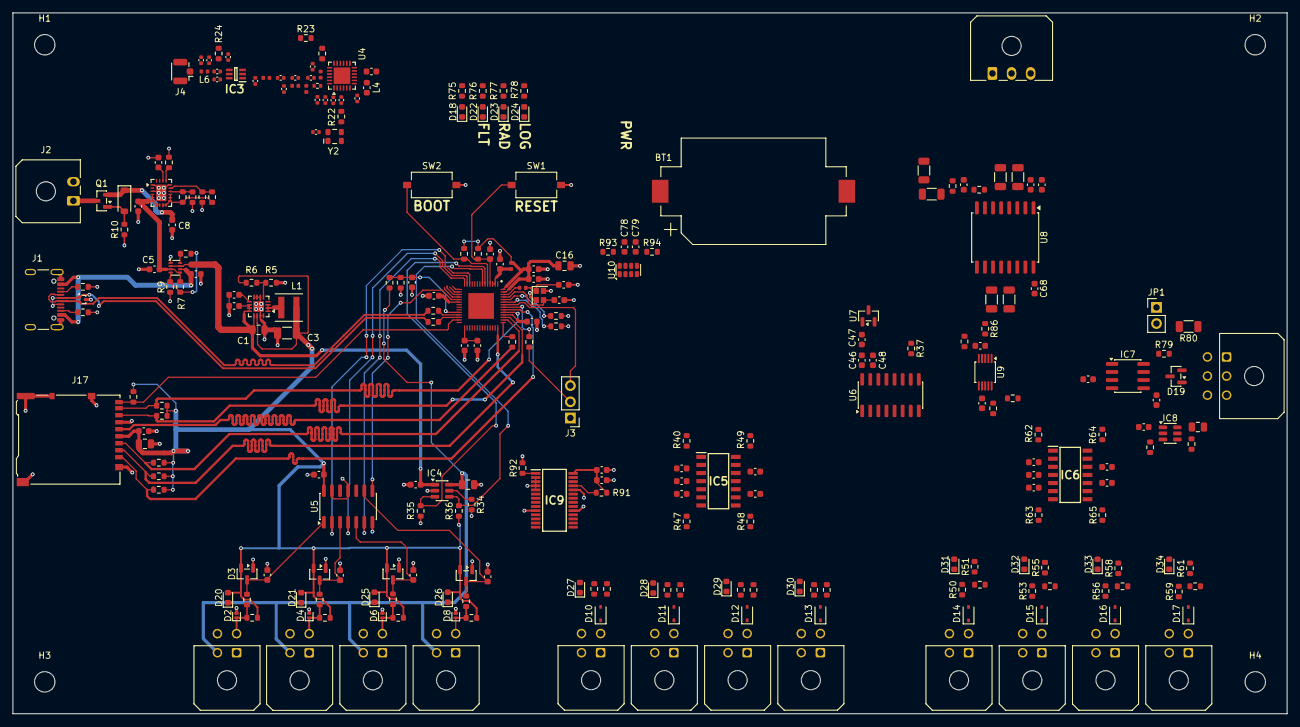
[picture p5: board rtlm.kicad_pcb from above]

Board: 4 copper layers, 200.0 x 110.0 mm, 265 parts (0 on the bottom side), 172 nets.

Other parts of the board:
H1, H2, H3, H4: MountingHole_3.2mm_M3
