Open-Racing-Telemetry/rtlm/(commit log)

2026-09-18 feat: basic kicad power handling in schematic
    [rtlm.kicad_pcb, rtlm.kicad_sch]
2026-09-18 feat: start LoRa, finish basic ESP32 schematic
    [rtlm.kicad_sch]
2026-09-21 feat: basic LoRa module complete
    [rtlm.kicad_sch]
2026-09-22 feat: basic sensor support
    [rtlm.kicad_sch]
2026-09-23 feat: status LEDs, more sensor ports, start CAN, SD card
    [rtlm.kicad_sch]
2026-09-24 feat: battery voltage sensing, sensor LEDs, start fixing footprint issues
    [rtlm.kicad_sch]
2026-09-25 feat: RTC, cleanup footprints
    [rtlm.kicad_sch]
2026-09-26 feat: finish schematic, fix footprints and verify components
    [rtlm.kicad_sch]
2026-09-26 feat: start prelim PCB layout
    [rtlm.kicad_pcb]
2026-09-28 feat: prelim PCB layout, no routing
    [rtlm.kicad_pcb]
2026-09-30 chore: update history
    [rtlm.kicad_pcb]
2026-10-01 feat: remove battery passthrough, start routing
    [rtlm.kicad_pcb, rtlm.kicad_sch]
2026-10-01 feat: start routing power input
    [rtlm.kicad_pcb]
2026-10-04 feat: USB routing, thermal vias
    [rtlm.kicad_pcb, rtlm.kicad_sch]
2026-10-04 feat: more thermal vias, start power routing
    [rtlm.kicad_pcb]
2026-10-05 fix: cleanup routing and set uniform trace widths; fix DRC errors
    [rtlm.kicad_pcb]
2026-10-05 fix: remove stray traces
    [rtlm.kicad_pcb]
2026-10-05 feat: start IC1 routing, SD, and UART; fix misnamed UART label
    [rtlm.kicad_pcb, rtlm.kicad_sch]
2026-10-06 feat: SD routing, incomplete IC1 side.
    [rtlm.kicad_pcb]
2026-10-18 feat: finish pulse routing, start status LED routing
2026-10-19 feat: power planing
